nengjieshen/-/设计说明书/论文提纲.docx

1. 结构设计
1） 整体结构设计及校核（5000字）
1. 整体结构设计思路及准则（腿部原理图、总装图、机械原理图）（1000字）
（1） 机器人总装（图）
（2） 腿部原理（图）
（3） 三个版本躯干尺寸（图）
（4） 吸附方案对比（表）
2. 零件材料及加工工艺（支撑件零件图）
3. 关节连接件强度校核（关节连接件零件图）
4. 关节舵机扭矩校核（关节舵机参数表）
2） 吸附机构设计及校核（5000字）
1. 吸附机构设计方案
2. 真空负压方案可行性校核（气压控制原理图）
3. 单涵道风扇方案可行性校核（扇叶、无刷电机参数表）
4. 双涵道风扇方案可行性校核
2. 硬件设计
1） 主控电路设计（3000字）
1. 电源电路设计
2. 自锁开关电路设计
3. 单总线串口通信电路设计
4. 接口电路设计
2） 关节驱动电路设计（3000字）
1. 电源电路设计
2. 单总线串口通信电路设计
3. 电流检测电路设计
3） 传感器电路设计（3000字）
1. 激光测距传感器电路设计
2. 电流传感器电路设计
4） 短距无线控制概念构想（3000字）
1. 概述
2. 基于NRF905芯片的无线广播通信伺服舵机
3. 基于ESP32系列芯片的WiFi无线通信伺服舵机
3. 程序设计
1） 单总线控制程序设计（2000字）
2） 关节位置PID闭环反馈调节程序设计（2000字）
3） 基于电流闭环的关节力矩控制程序设计（2000字）
