nengjieshen/-/结构设计/气动系统原理图.png

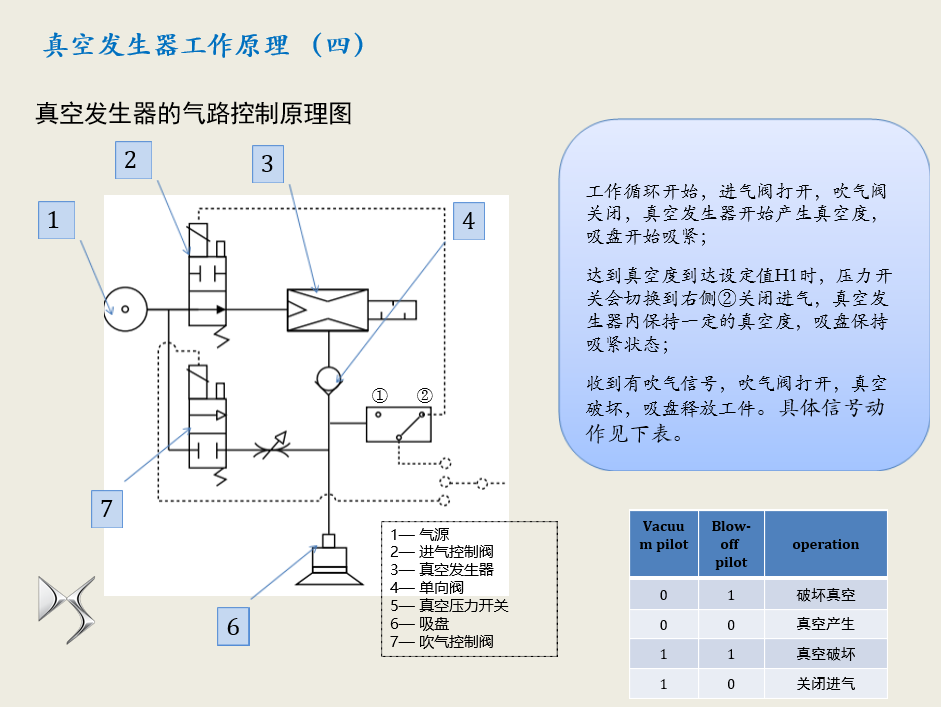
结构设计/气动系统原理图.png
