nengjieshen/-/主控转接板-V1.0/主控转接板-V1.0/主控转接板-V2.0/主控转接板BOM-V2.0.xlsx

型号 | 封装 | 位号 | 用量 | 备注
Header 3 |  | BUS1 BUS2 | 2
10uF | 0603 | C1 C2 | 2
100nF | 0603 | C3 C_K1 | 2
2.2uF | 0603 | C_K2 | 1
LED | 0603 | LED? | 1
Header 4 | MP2315GJ | P0 | 1 | 5V稳压模块
Header_1×2 |  | PW1 PW2 | 2
S8050 | SOT-233 | Q1 Q_K3 | 2
S8550 | SOT-233 | Q_K1 | 1
KRC106S | SOT-233 | Q_K2 | 1
1KΩ | 0603 | R3 R1 | 2
10KΩ | 0603 | R2 R_K1 R_K5 R_K2 R_K4 R_K8 | 6
4.7KΩ | 0603 | R_J1 R_J2 R_K3 | 3
510KΩ | 0603 | R_K7 | 1
100Ω | 0603 | R_K6 | 1
Buttom | Touch Switch | S1 | 1 | 触碰开关
XC6206P332MR | SOT-233 | U1 | 1
SN74LVC2G126 | VSSOP-8 | U2 | 1
JY901 | 标准版 | U3 | 1
AO4423 | SOP-8 | U4 U5 | 2
Header 40 | 2*20 2.54标准排母 | U？ | 1
