nengjieshen/-/总线驱动板/总线驱动板/总线驱动板-V1.0/总线驱动板_BOM.xlsx

编号 | 元件 | 封装 | 数量
1 | STM32F103C8T6 | LQFP-48 | 5
2 | 16M有源晶振 | 5032 | 5
3 | AMS1117-3.3 | SOT-89 | 5
4 | AMS1117-5.0 | SOT-89 | 5
5 | SN74LVC2G126 | VSSOP-8 | 5
6 | LM2596-adj | TO-263-5 | 5
7 | 74V1G14 | SOT-23-5 | 15
8 | 直插电解电容100uF | 直径8mm | 5
9 | 直插电解电容220uF | 直径8mm | 5
10 | 68uH贴片功率电感 | 7*7*4mm | 5
