nengjieshen/-/总线驱动板/总线驱动板/总线驱动板-V1.0/总线驱动板-V1.SLDPRT

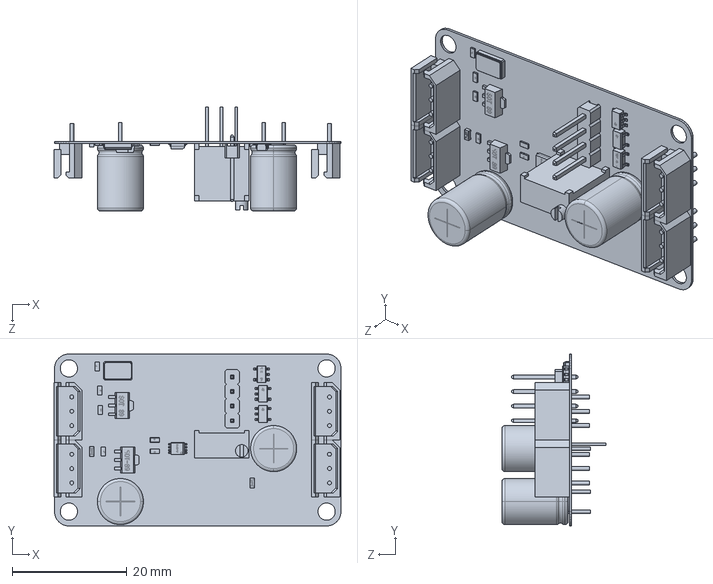
[picture p21: CAD file, 2019-05-22]
总线驱动板/总线驱动板/总线驱动板-V1.0/总线驱动板-V1.SLDPRT
50.1 x 30.0 x 18.2 mm
