nengjieshen/-/(list of files, cad)

Other CAD files:
总装图4-24.dwg
结构设计/腿.DWG
总装图5-13.dwg
结构设计/小腿连接件.DWG
总装图5-12.dwg
结构设计/无刷电机.DWG
总装图5-14.dwg
结构设计/腿部结构原理图.dwg
三视图.DWG
总五图黑色.dwg
总装图.DWG
