nengjieshen/-/主控转接板-V1.0/主控转接板-V1.0/主控转接板-V1.0.PDF

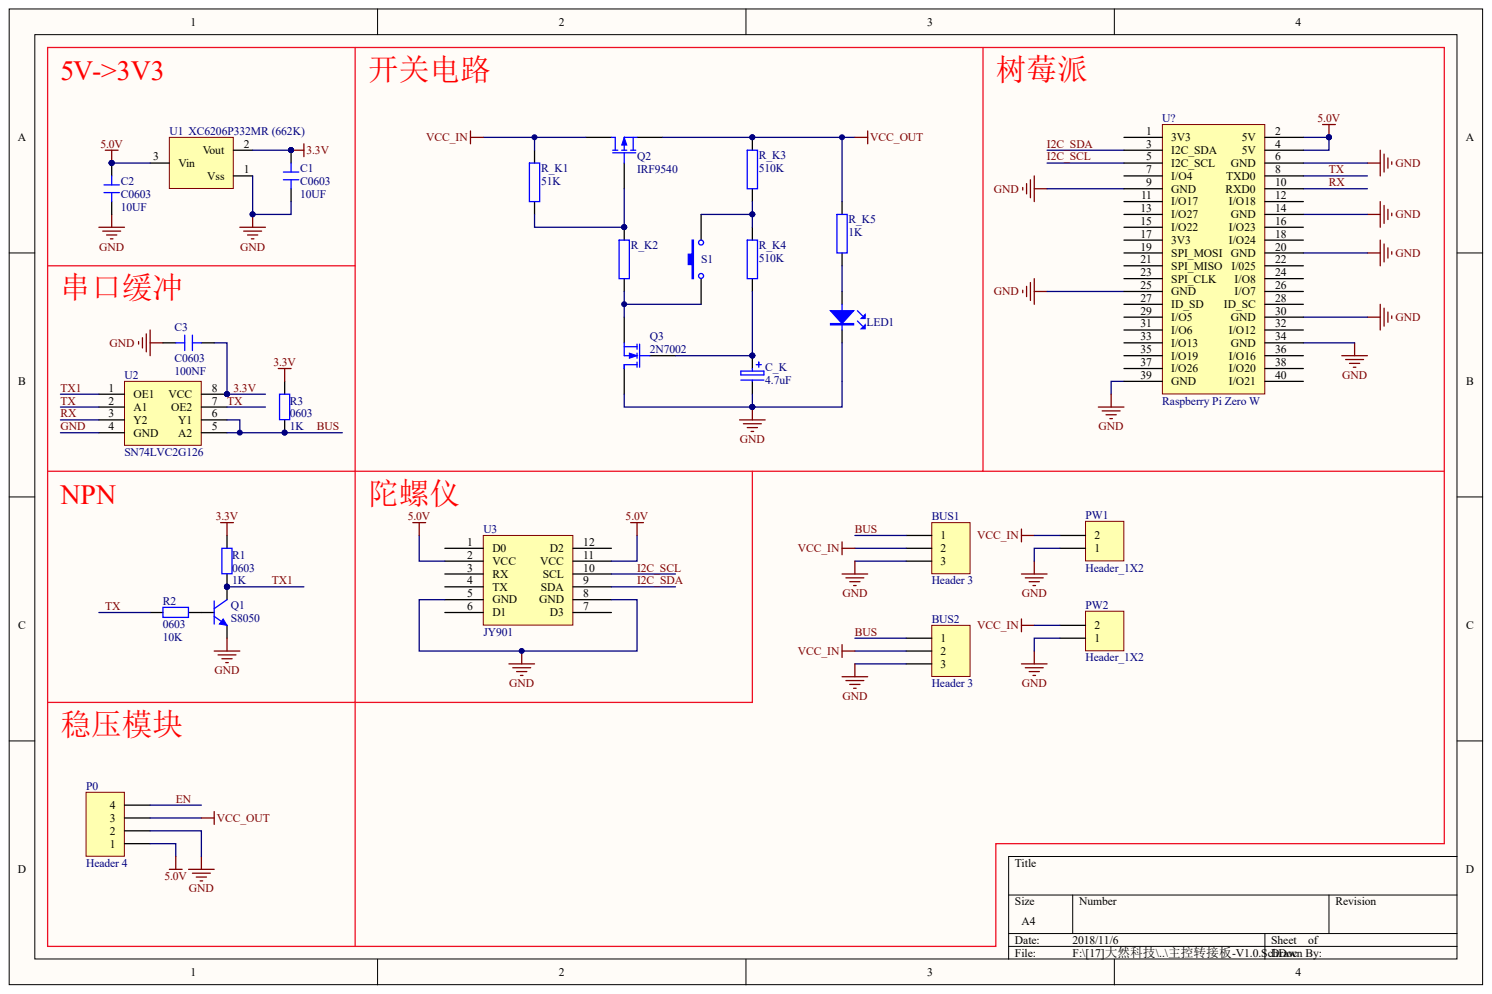
[picture p22: page 1]

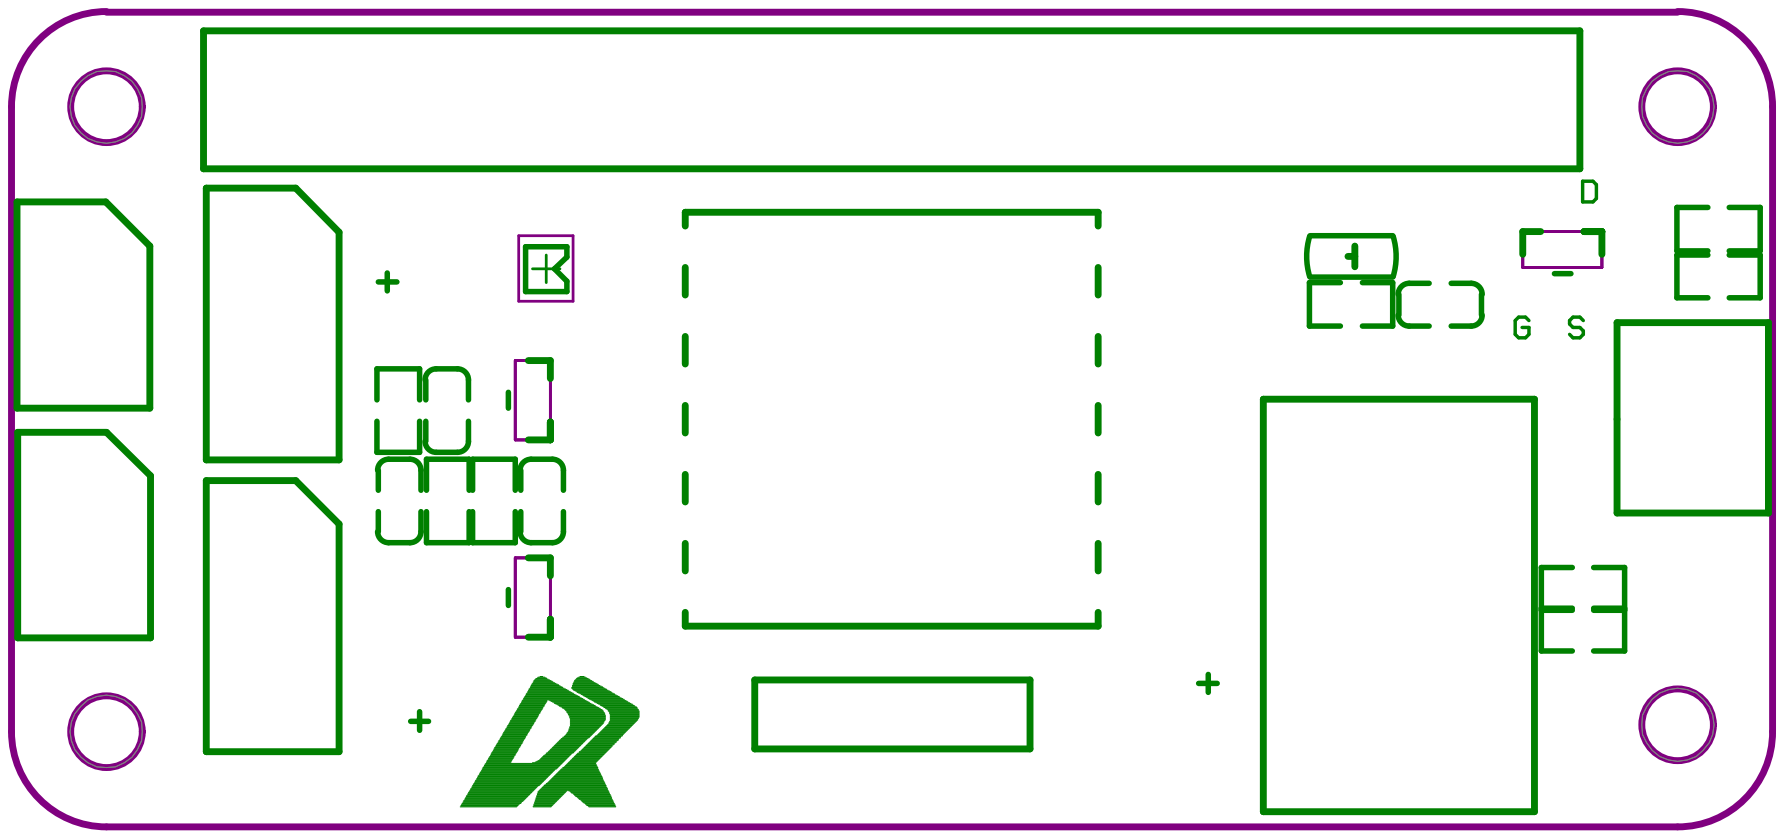
[picture p23: page 2]

Comment | Description | Designator | Footprint | LibRef | Quantity
Header 3 | Header, 3-Pin | BUS1, BUS2 | 3P | Header 3 | 2
C0603 | | C1, C2, C3 | Cap_0603 | Cap 1 | 3
4.7uF | Electrolytic Capacitor | C_K | Cap_0603 | CAP_C | 1
LED | LED | LED1 | LED_0603 | LED | 1
Header 4 | Header, 4-Pin | P0 | MP2315GJ | Header 4 | 1
Header_1X2 | | PW1, PW2 | 2P | Header_1X2 | 2
S8050 | | Q1 | LC-SOT-23(SOT-23-3) | NPN | 1
IRF9540 | P-Channel MOSFET | Q2 | SOT-263 | MOSFET-P | 1
2N7002 | N-Channel MOSFET | Q3 | LC-SOT-23(SOT-23-3) | MOSFET-N | 1
0603 | | R1, R2, R3 | Res_0603 | Res2 | 3
51K | Resistor | R_K1 | Res_0603 | RES | 1
| Resistor | R_K2 | Res_0603 | RES | 1
510K | Resistor | R_K3, R_K4 | Res_0603 | RES | 2
1K | Resistor | R_K5 | Res_0603 | RES | 1
SW-PB | Switch | S1 | Touch Switch | SW-PB | 1
XC6206P332MR (662K) | | U1 | LC-SOT-23(SOT-23-3) | XC6206P332MR (662K) | 1
SN74LVC2G126 | | U2 | VSSOP-8 | SN74LVC2G126 | 1
JY901 | | U3 | JY901 | JY901 | 1
Raspberry Pi Zero W | | U? | 2.54 2*20PIN | Raspberry Pi Zero W | 1
