nengjieshen/-/结构设计/腿部结构原理图.pdf

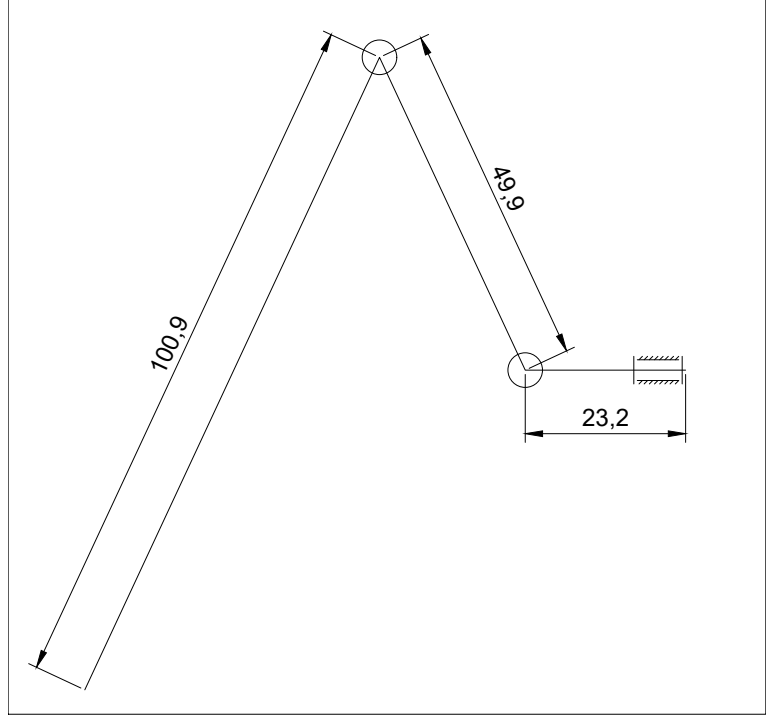
[picture p27: page 1]
