nengjieshen/-/(list of files, drawings)

Other design files:
主控转接板-V1.0/主控转接板-V1.0/主控转接板-V1.0.PcbDoc
主控转接板-V1.0/主控转接板-V1.0/主控转接板-V1.0.PcbLib
主控转接板-V1.0/主控转接板-V1.0/主控转接板-V1.0.PrjPCB
主控转接板-V1.0/主控转接板-V1.0/主控转接板-V1.0.SchDoc
主控转接板-V1.0/主控转接板-V1.0/主控转接板-V2.0/主控转接板-V2.0.PcbDoc
主控转接板-V1.0/主控转接板-V1.0/主控转接板-V2.0/主控转接板-V2.0.PrjPCB
主控转接板-V1.0/主控转接板-V1.0/主控转接板-V2.0/主控转接板-V2.0.SchDoc
总线驱动板/总线驱动板/总线驱动板-V1.0/总线驱动板-V1.0.PcbDoc
总线驱动板/总线驱动板/总线驱动板-V1.0/总线驱动板-V1.0.PrjPCB
总线驱动板/总线驱动板/总线驱动板-V1.0/总线驱动板-V1.0.SchDoc
