nengjieshen/-/总线驱动板/总线驱动板/CCS811_EC/CCS811_EC/src/Global.h

#ifndef __GLOBAL_H__
#define __GLOBAL_H__

/*-----------------------------------------  I N C L U D E S  -----------------------------------------*/
#include <stdio.h>
#include "stm32f10x.h"
#include "stm32f10x_conf.h"
#include "stm32f10x_it.h"
#include "misc.h"
#include "sys.h"
#include "Delay.h"
#include "IO_input.h"
#include "IO_output.h"
#include "oled.h"
#include "ADC.h"
#include "Timer.h"
#include "Usart.h"
#include "CCS811_IIC.h"
#include "CCS811.h"
#include "PWM.h"

#endif
