nengjieshen/-/总线驱动板/总线驱动板/CCS811_EC/CCS811_EC/src/IO_output.c

#include "IO_output.h"

void OutputIOInit(void)
{
	GPIO_InitTypeDef GPIO_InitStructure;

	RCC_APB2PeriphClockCmd(RCC_APB2Periph_GPIOB, ENABLE);
	GPIO_InitStructure.GPIO_Pin  = GPIO_Pin_9|GPIO_Pin_8;
	GPIO_InitStructure.GPIO_Mode = GPIO_Mode_Out_PP;
	GPIO_InitStructure.GPIO_Speed = GPIO_Speed_50MHz;
	GPIO_Init(GPIOB, &GPIO_InitStructure);

//	RCC_APB2PeriphClockCmd(RCC_APB2Periph_GPIOC, ENABLE);
//	GPIO_InitStructure.GPIO_Pin  = GPIO_Pin_13;
//	GPIO_InitStructure.GPIO_Mode = GPIO_Mode_Out_PP;
//	GPIO_InitStructure.GPIO_Speed = GPIO_Speed_50MHz;
//	GPIO_Init(GPIOC, &GPIO_InitStructure);
}
