nengjieshen/-/(notices)

Notices in the files:
总线驱动板/总线驱动板/CCS811_EC/CCS811_EC/src/oled.h:
Copyright(C) ÖÐ¾°Ô°µç×Ó2014/3/16
All rights reserved
